DawidSzcz/attendence_verifier/README.md

# Arduino
W folderze verifier_board znajduje się kod wgrany na Arduino.

Fotografie urządzenia na bazie arduino:

Zmotowane urządzenie

# Attendence Verifier
Podrepozytorium z kodem aplikacji do zarządzania obecnością studentów na wykładzie w php/yii2.

Więcej informacji wewnątrz submodułu.

# Praca
Tekst pracy magisterskiej w tex/pdf

# Student Base
Podrepozytorium z kodem aplikacji do zarządzania danymi studentó w php/symfony4. 

Więcej informacji wewnątrz submodułu.
