DawidSzcz/attendence_verifier/praca/dawid_szczyrk_258352.tex

 % Opcje klasy 'iithesis' opisane sa w~komentarzach w~pliku klasy. Za ich pomoca
% ustawia sie przede wszystkim jezyk i~rodzaj (lic/inz/mgr) pracy, oraz czy na
% drugiej stronie pracy ma byc skladany wzor oswiadczenia o~autorskim wykonaniu.

\documentclass[declaration,shortabstract, mgr]{iithesis}
\usepackage{graphicx}
\usepackage[utf8]{inputenc}
\usepackage{url}

%%%%% DANE DO STRONY TYTUłOWEJ
% Niezaleznie od jezyka pracy wybranego w~opcjach klasy, tytul i~streszczenie
% pracy nalezy podac zarowno w~jezyku polskim, jak i~angielskim.
% Pamietaj o~madrym (zgodnym z~logicznym rozbiorem zdania oraz estetyka) recznym
% zlamaniu wierszy w~temacie pracy, zwlaszcza tego w~jezyku pracy. Uzyj do tego
% polecenia \fmlinebreak.
\polishtitle {System kontroli obecności na podstawie elektronicznych legitymacji studenckich}
\englishtitle {Students attendance verification system\\ with the use of electronic student's card}
\polishabstract{
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
\indent Dodatkowo w~ramach referowanego projektu wykonano internetową aplikację - elektroniczny dziennik - umożliwiającą katalogowanie zebranych przy pomocy weryfikatora obecności.
Użytkownikowi umożliwiono zarejestrowanie indywidualnego konta w~serwisie, w~którego kontekście możliwe jest tworzenie struktury wykładów i~zajęć odpowiadającej rzeczywistemu kalendarzowi prowadzącego. Aplikacja została wykonana przy użyciu frameworka języka PHP - Yii2.
Wirtualny dziennik nie przechowuje informacji o~studentach i~do poprawnego działania wymaga dostępu do serwisu udostępniającego takie dane.\\
\indent Podczas pracy nad projektem nie było możliwości podłączenia się do żadnego istniejącego systemu uczelnianego udostępniającego dane studentów. Z~tego powodu, jako element projektu, została stworzona aplikacja - w~oparciu o~framework Symfony4 - umożliwiająca pobranie danych studenta i~udostępniająca w~tym celu RESTowe API.\\
\indent Obie stworzone aplikacje wraz z~połączonymi z~nimi bazami danych osadzone zostały w~chmurze w~sposób zapewniający bezpieczeństwo i~niezawodność.}

\englishabstract{
\begin{center}
\subsubsection{Abstract}
\end{center}
\indent Within the following project, a~student attendance verification system with usage of Electronic Students Card (ESC) was developed. \\
\indent The presented work describes a~process from problem analysis and demands defining to developing the final version of the multi-component project. The final system consists of Internet applications for collecting and managing students presence data, and an electronic device made for this project with the usage of the Arduino platform. \\
\indent The electronic device - the verificator - provides a~comprehensive user interface and is responsible for collecting data about student presences. The final circuit was made based on the Arduino Uno board, extended with plenty of additional parts such as an RFID module and USB Host Shield. All interconnected parts were put in a~plastic box to make it comfortable for use and transportation. \\
\indent For managing data collected by the verificator, an Internet application was developed. It allows a~user to create an account, and manage presences data in its context. It is possible to create a~composition of lectures and classes, which corresponds with the real calendar of a~lecturer. It was developed with the usage of the PHP framework - Yii2. \\
\indent The system was designed not to relate to concrete student's data management system, in order to be flexible about a~university system it is connected with. \\
\indent Additionally, a~system which correlates the Electronic Student Card UID with the information about students was developed. It provides REST API, to retrieve demanded information. The implementation provides fake data but can be easily replaced by real API. It was created based on the PHP framework - Symfony4. \\
\indent Both created services along with databases connected with them were deployed in the cloud system with respect to proper security and reliability standards.
}
% w pracach wielu autorow nazwiska mozna oddzielic poleceniem \and
\author {Dawid Szczyrk}
% w przypadku kilku promotorow, lub koniecznosci podania ich afiliacji, linie
% w ponizszym poleceniu mozna zlamac poleceniem \fmlinebreak
\advisor {dr Jakub Michaliszyn}
%\date {} % Data zlozenia pracy
% Dane do oswiadczenia o~autorskim wykonaniu
%\transcriptnum {} % Numer indeksu
%\advisorgen {dr. Jana Kowalskiego} % Nazwisko promotora w dopelniaczu
%%%%%

%%%%% WLASNE DODATKOWE PAKIETY
%
%\usepackage{graphicx,listings,amsmath,amssymb,amsthm,amsfonts,tikz}
%
%%%%% WłaASNE DEFINICJE I POLECENIA
%
%\theoremstyle{definition} \newtheorem{definition}{Definition}[chapter]
%\theoremstyle{remark} \newtheorem{remark}[definition]{Observation}
%\theoremstyle{plain} \newtheorem{theorem}[definition]{Theorem}
%\theoremstyle{plain} \newtheorem{lemma}[definition]{Lemma}
%\renewcommand \qedsymbol {\ensuremath{\square}}
% ...
%%%%%

\begin{document}

\chapter{Wprowadzenie}

\indent Panująca na świecie pandemia COVID-19 zmusiła ludzi do porzucenia wielu do tej pory dobrze sprawdzających się rozwiązań na rzecz takich, które pomogą zapobiec rozprzestrzenianiu się wirusa. Gospodarki i~codzienne życie ludzi zostały przestawione na tryby tzw. nowej normalności.\\
\indent W niemniejszym stopniu obecna sytuacja dotknęła pracy uniwersytetów. Po okresie zdalnego nauczania, wraz z~nowym rokiem akademickim tradycyjne formy nauczania wracają do sal wykładowych, a~troska o~bezpieczeństwo studentów i~pracowników uniwersytetu narzuca reorganizację życia akademickiego.\\
\indent Jednym z~elementów funkcjonowania instytucji naukowych, który powinien zostać dostosowany do nowych wymogów sanitarnych, jest prowadzenie listy obecności na zajęciach stacjonarnych. Zgodnie z~ustępem 3 paragrafu 2 zarządzenia nr 116/2020 rektora Uniwersytetu Wrocławskiego \cite{uwr} podczas wszystkich zajęć na uczelni, które odbywają się w~formie stacjonarnej lub hybrydowej obligatoryjne jest prowadzenie listy obecności uczestników zajęć. Obecna forma realizowana poprzez podawanie sobie przez studentów kartki, na której spisane zostają ich dane, prowokuje dodatkowe niebezpieczeństwo zakażenia wirusem. \\
\indent Dodatkową zachętą do usprawnienia obecnego rozwiązania, jest cytowane powyżej zarządzenie rektora Uniwersytetu Wrocławskiego ustalające, że od semestru zimowego 2020 na wszystkich prowadzonych zajęciach obowiązkowe jest zbieranie listy obecności. \\
\indent Względy zdrowotne nie są jedynym uzasadnieniem konieczności optymalizacji identyfikowania osób biorących udział w~zajęciach. Obecna forma tego procesu jest uciążliwa, zajmuje kilka pierwszych minut zajęć, a~studenci się rozpraszają podając sobie listę obecności. Istotnym czynnikiem, który należy wziąć pod uwagę jest również ochrona danych osobowych, do której w~dzisiejszym świecie przykłada się coraz większą wagę.\\
\indent W dobie współczesnych zdobyczy technologicznych można uznać za zaskakujące, że wciąż trwamy przy tym procesie. Wydawać by się mogło, że obecne podejście jest tak zakorzenione w~akademickiej kulturze, że nie ma możliwości go zmienić. Istnieją jednak opracowania, które wskazują, że warto jest wdrażać nowoczesne rozwiązania, ponieważ ma to bezpośrednie przełożenie na prędkość sprawdzania obecności \cite{lcd}. Zostało dodatkowo sprawdzone \cite{theory_base}, że obecność ma wprost proporcjonalny wpływ na wyniki w~nauce i~odsetek uczniów porzucających studia przed ich ukończeniem. Wskazane zostało, że sprawdzanie obecności ma znaczenie nie tylko jako forma przymusu, ale również jako wyraz troski uczelni o~swoich studentów i~ma wpływ na ich morale.\\

\chapter{Analiza problemu}
\section{Przegląd obecnego sposobu sprawdzania obecności}
\indent W celu doprecyzowania wymagań stawianych przed projektowanym systemem rozważono proces weryfikowania obecności na zajęciach prowadzonych przez Uniwersytet Wrocławski\\
\indent Sprawdzanie listy uczestnictwa jest w~dużej mierze uzależnione od preferencji prowadzącego i~zwyczajów panujących na konkretnym wydziale - przykładowo obecność może być potwierdzona słownie - poprzez kolejne wywołanie osób z~listy albo pisemnie - poprzez udostępnienie listy, na którą uczestnicy będą zobowiązani się wpisać.\\
\indent Dla uproszczenia dalszych rozważań przyjęto za ogólnie stosowaną metodę pisemną - która według obserwacji autora jest stosowana częściej - i~na tej podstawie wyodrębnić czynności, które składają się na wypełnienie listy obecności.\\
\indent Weryfikacja uczestnictwa w~zajęciach jest czynnością na pozór oczywistą, po bliższym przyjrzeniu się całej procedurze okazuje się jednak, że daje się ona rozłożyć na jeszcze prostsze elementy. \\

\begin{itemize}
\item Przygotowanie kartki z~listą obecności (przypisanie listy obecności do zajęć których będzie ona dotyczyła).
\item Udostępnienie kartki uczestnikom oraz wpisywanie się na listę.
\item Weryfikacja poprawności zebranej listy poprzez przeliczenie osób obecnych na zajęciach.
\item Przeniesienie zebranych danych do uczelnianego systemu.
\end{itemize}

\indent Powyższy schemat zbierania listy obecności podatny jest na dodatkowe błędy. Nie trudno wyobrazić sobie sytuację, w~której student intencjonalnie podał nie swoje dane w~celu zaliczenia obecności innej osobie. Kolejnym czynnikiem, który może doprowadzić do błędów na ostatecznej liście obecności jest błąd ludzki podczas przenoszenia danych z~kartki do uczelnianego systemu komputerowego. Taki błąd trudno jest od razu wychwycić ze względu na to, że studenci zazwyczaj nie przeglądają na bieżąco list obecności dostępnych np. na USOSie.\\
\indent Pierwszym elementem nadającym się do usprawnienia jest samo tworzenie listy obecności z~informacją na temat zajęć, których ta lista będzie dotyczyła. Fizyczna lista, poza czasem poświęconym na jej stworzenie, musi być po odbytych zajęciach przechowywana - co stwarza ryzyko jej zgubienia. Dodatkowo istnieje prawdopodobieństwo, że trafi w~niepowołane ręce i~ktoś wpisze na nią dodatkowe nazwiska. Do tego wszystkiego dochodzi jeszcze aspekt ekologiczny, ponieważ każda kolejna kartka generuje wymagające utylizacji śmieci. \\
\indent Również udział studentów w~rejestrowaniu własnej obecności może ulec optymalizacji. Wpisanie własnego imienia i~nazwiska, a~czasem numeru albumu zabiera czas, naraża na upublicznienie dane osobowe i~utrudnia studentowi śledzenie wykładu.\\
\indent Weryfikacja poprawności listy jest nie tylko pracochłonna, ale również podatna na błędy. Czas poświęcony na policzenie uczestników rośnie wprost proporcjonalnie do ich liczby. Dodatkowo prowadzący zajęcia może się pomylić lub ktoś może dopisać się do listy już po tym sprawdzeniu.\\
\indent Z całą pewnością usprawnienia wymaga proces przenoszenia danych z~fizycznego nośnika do uczelnianego systemu komputerowego. Problemem jest nie tylko to, że podczas wpisywania obecności do komputerowego systemu można popełnić błąd, ale również to, że jest to proces czasochłonny.\\

\section{Istniejące i~możliwe realizacje zagadnienia}
\subsection{Podłączenie czytnika RFID bezpośrednio do komputera}
\indent Popularnym pomysłem usprawniającym system weryfikacji obecności jest skorzystanie technologii RFID (Radio-frequency identification). Wykorzystuje ona pole elektromagnetyczne do śledzenia na niewielkie odległości tagów (etykiet) RFID\cite{rfid_itself} - małych transmiterów fal radiowych zdolnych do przechowywania danych umożliwiających zdalną identyfikację. Tagi często mają formę kart, breloków lub innych łatwych w~transporcie i~przechowywaniu przedmiotów.\\
\indent W opracowaniu \cite{rfid_serial} przedstawiono projekt weryfikatora obecności zrealizowany przy pomocy radio technologii. Każdemu studentowi został przypisany tag z~unikatowym identyfikatorem. System składa się z~czytnika etykiet podłączonego do komputera przy użyciu portu szeregowego oraz aplikacji komputerowej zdolnej do rozpoznawania zbliżonych do czytnika tagów i~zapamiętywania którzy studenci zeskanowali swoje karty w~trakcie zajęć. \\
\indent Ciekawym pomysłem przedstawionym w~tym projekcie jest przekazanie osobnego tagu prowadzącemu zajęcia. Zbliżenie tej etykiety na początku i~na końcu zajęć do czytnika wyznacza ramy czasowe, podczas których obecność może zostać zaliczona studentom. Dodatkowo zastosowano tutaj podejście, w~którym uczestnik powinien rejestrować swoje pojawienie się, jak i~opuszczenie zajęć - jest to odstępstwo od tradycyjnej formy zbierania obecności. \\
\indent W projekcie można zaobserwować kilka wad. Wykorzystany czytnik RFID jest urządzeniem w~całości dostarczonym przez producenta. Można spodziewać się że jest to rozwiązanie drogie, a~samego urządzenia nie będzie dało się rozszerzyć o~dodatkowe funkcjonalności. \\
\indent Taka architektura pociąga za sobą konieczność ciągłego połączenia z~komputerem oraz dodatkowego okablowania. Może to powodować problemy logistyczne, jeśli trzeba korzystać z~systemu w~różnych salach.\\
\indent Sama aplikacja komputerowa katalogująca zebrane obecności również poddana jest ograniczeniom. Korzystanie z~tego systemu możliwe jest wyłącznie na komputerach, na których zainstalowano taką aplikację, co jest rozwiązaniem uciążliwym. Baza danych zapamiętująca obecności współdzielona jest pomiędzy poszczególne instancje aplikacji na różnych komputerach, jest więc ona udostępniona publicznie, co ułatwia nieautoryzowany dostęp.

\subsection{Podłączenie przy pomocy kabla ethernetowego}
\indent W opracowaniu opisanym w~pracy\cite{ethernet} zaproponowano podobną realizację, tym razem w~oparciu o~bezpośrednie podłączenie czytnika do internetu kablem RJ45. Wykorzystywane urządzenie jest stworzone na bazie Arduino Uno rozszerzonym o~moduł RFID i~gniazdo pozwalające podłączyć kabel ethernetowy. \\
\indent Zaproponowany projekt rozwiązuje problem konieczności korzystania z~komputera w~bezpośrednim połączeniu z~czytnikiem, a~wybrany układ elektroniczny pozwala rozszerzyć urządzenie o~dodatkowe funkcjonalności. Łączność internetowa pozwala na natychmiastowe odnotowywanie obecności w~bazie, co na pewno jest wygodnym rozwiązaniem. \\
\indent W treści opracowania nie został poruszony problem połączenia obecności z~zajęciami, na których została ona odnotowana. W~przypadku rozszerzenia systemu o~kolejne czytniki podłączone do sieci i~korzystania z~wielu urządzeń jednocześnie, nie będzie możliwości rozszyfrowania, z~jakich zajęć pochodzą spływające do serwera dane. \\
\indent Jedynym możliwym sposobem na komunikację urządzenia z~użytkownikiem jest w~tym wypadku buzzer, co może okazać się niewystarczające do wyrażenia stanu urządzenia. W~razie kłopotów z~łącznością albo anteną RFID nie ma możliwości wygodnego sygnalizowania problemu.

\subsection{Samodzielny czytnik }
\indent W cytowanym we wstępie opracowaniu\cite{lcd}, w~celu rozwiązania powyższego problemu zaproponowano wykorzystanie z~wyświetlacza LCD, z~którego użytek robi opisany w~tej pracy układ elektroniczny. Przedstawione w~pracy urządzenie poza czytnikiem RFID, zdolne jest również do wyświetlania treściwych komunikatów potwierdzających udane odnotowanie karty studenta. \\
\indent Trudno jednak w~tym wypadku dyskutować z~innymi rozwiązaniami technicznymi zawartymi w~tej pracy, ponieważ motywem przewodnim tego opracowania jest pokazanie, że sprawdzanie obecności przy pomocy tagów RFID przebiega szybciej niż w~klasycznym podejściu.

\subsection{Aplikacja internetowa}
\indent To najprostsze rozwiązanie składające się z~jednolitego systemu, w~którym jednocześnie można odnotowywać obecności uczestników zajęć oraz je przechowywać i~przeglądać. Jej niewątpliwym plusem jest całkowite wyeliminowanie problemu związanego z~przenoszeniem danych do systemu katalogującego obecności, ponieważ dane wprowadzane są wprost do systemu. Identyfikacja konkretnych zajęć, w~ramach których rejestrowana jest obecność, odbywałaby się na początku zajęć poprzez wejście w~kontekst odpowiedniego wykładu w~aplikacji. Obecność uczestników na zajęciach byłaby sprawdzana przez prowadzącego i~od razu wprowadzana do systemu. \\

\subsection{Urządzenie rejestrujące obecności za pośrednictwem sieci bezprzewodowej}
\indent W przypadku tego rozwiązania mikrokontroler zastałby rozszerzony o~moduł do bezprzewodowej łączności z~internetem, a~stworzona aplikacja udostępniałaby interfejs do odnotowywania obecności. \\
\indent Na etapie planowanie tego rozwiązania wyniknęły komplikacje. Ten sposób wysyłania danych do aplikacji katalogującej obecności wymagałby umożliwienia powiązania obecności z~zajęciami, na których zostały zebrane. \\
\indent Wymagałoby to dołączenia dodatkowego interfejsu, który by to umożliwiał, co jeszcze bardziej komplikowałoby projektowane urządzenie. Dodatkowo ograniczyłoby to zbiór układów scalonych, z~których można by skorzystać, ponieważ musiałby on posiadać wystarczającą ilość pamięci, pinów i~innych potrzebnych peryferiów.

\section{Określenie wymagań wobec projektu}
\indent W poprzednim rozdziale wspomniano o~wielu możliwych realizacjach problemu weryfikowania uczestnictwa w~zajęciach, co jest tylko niewielkim wycinkiem możliwych do wykonania projektów. W~opracowaniu \cite{review} wspomniano o~wielu przedsięwzięciach, z~których na wyróżnienie zasługują:

\begin{itemize}
\item Skorzystanie z~telefonu komórkowego i~łączności bluetooth w~celu odnotowania obecności.
\item Wykorzystanie odcisku palca do dodatkowego potwierdzenia tożsamości studenta.
\item Użycie kamery i~rozpoznawania twarzy w~celu identyfikacji wchodzących na wykład studentów.
\end{itemize}

\indent Analiza powyższych rozwiązań wraz z~ich mocnymi i~słabymi stronami pozwoliła wyłonić zbiór wymagań wobec projektowanego systemu. Wymagania zostały dobrane pod kątem poprawienia wydajności klasycznego sposobu weryfikowania obecności, co zostało rozważone w~rozdziale 2.1, oraz możliwości jakie dają współczesne technologie, które zostały opisane powyżej.

\subsubsection{Urządzenie powinno udostępniać następujące funkcjonalności:}

\begin{enumerate}
\item Zarejestrowanie obecności uczestnika zajęć przy pomocy tagu RFID.
\item Wyświetlanie jasnych komunikatów odnośnie stanu urządzenia.
\item Powiązanie obecności z~zajęciami, podczas których zostały zebrane.
\item Potwierdzenie tożsamości uczestnika odnotowującego swoją obecność.
\item Katalogowanie zebranych danych i~generowanie raportów podsumowujących.
\item Wygodne przeniesienie obecności zebranych przez czytnik do aplikacji przechowującej dane.
\end{enumerate}

\section{Określenie struktury projektu}
\indent Finalnie w~referowanym projekcie rozdzielono proces zbierania danych od ich przechowywania i~przetwarzania.\\
\indent Realizacja projektu opiera się na fakcie, że polskie uczelnie powszechnie korzystają z~Elektronicznych Legitymacji Studenckich (ELS), które zawierają wbudowany tag RFID. \\
\indent Komponent umożliwiający studentowi odnotowanie swojej obecności na wykładzie - weryfikator - został oparty o~platformę Arduino. Urządzenie zostało rozszerzone o~moduły umożliwiające realizację założeń z~poprzedniego rozdziału.\\
\indent Dodatkowo częścią urządzenia będzie zegar RTC umożliwiający zapamiętanie godziny, o~której odnotowane zostały obecności, a~więc powiązanie ich z~konkretnymi zajęciami, oraz wyświetlacz LCD + Buzzer, pozwalające na wygodne korzystanie z~samodzielnego urządzenia. \\
\indent Sposobem na potwierdzenie tożsamości studenta będzie w~wypadku realizowanego projektu porównanie zdjęcia na legitymacji z~twarzą osoby, która zbliża ją do czytnika. Za tę weryfikację odpowiedzialny będzie prowadzący.\\\\

\indent Rolę oprogramowania odpowiedzialnego za katalogowanie zebranych przez weryfikator danych będzie pełnić ogólnodostępna aplikacja internetowa - elektroniczny dziennik, umożliwiający założenie konta i~zarządzanie zebranymi obecnościami w~kontekście całego przedmiotu i~w kontekście pojedynczych zajęć. Dodatkowo ma on umożliwiać generowanie raportów ze zagregowanymi danymi tak, aby dało się łatwo prześledzić obecności w~kontekście całego semestru. \\
\indent Wirtualny dziennik zaprojektowano w~taki sposób, żeby był niezależny od danych studentów. Dzięki takiemu podejściu w~łatwy sposób można przełączyć cały system na korzystanie z~baz danych na różnych uczelniach. Uniknie się także konieczności przechowywania wrażliwych danych w~systemie. \\
\indent Ze względu na to, że na etapie realizowania założonego projektu nie uzyskano dostępu do serwisu udostępniającego dane wrocławskich studentów, została stworzona dodatkowa aplikacja, niezależna od innych części projektu. Umożliwia ona powiązanie danych pobranych z~legitymacji studenckiej z~danymi pozwalającymi na identyfikację jej posiadacza. Jest to aplikacja rozłączna względem systemu zarządzającego obecnościami osób uczestniczących w~zajęciach, wystawiająca RESTowe API.

\chapter{Realizacja}
\section{Weryfikator - czytnik legitymacji studenckich}
\indent Zgodnie z~wymaganiami projektowane urządzenie powinno udostępniać co najmniej następujące możliwości:
\begin{itemize}
\item Podłączenie zewnętrznego nośnika danych.
\item Stworzenie pliku, na którym zapamiętani zostaną uczestnicy zajęć.
\item Zebranie informacji z~elektronicznej legitymacji studenckiej, potwierdzające obecność uczestników.
\item Wyświetlanie informacji o~stanie urządzenia, w~szczególności sukcesu odczytania danych z~legitymacji.
\item Zapamiętanie czasu, w~którym zebrane zostały obecności.
\end{itemize}
\indent Dodatkowo cała elektronika powinna zostać schowana wewnątrz plastikowego opakowania, a~zasilanie dostarczane za pomocą przenośnego akumulatora lub kabla podłączonego do sieci elektrycznej. Opakowanie powinno zostać wyposażone w~otwory na kabel zasilający, zewnętrzny nośnik danych oraz wyświetlacz. Czytnik kart RFID powinien być tak zlokalizowany, aby umożliwić łatwe zebranie danych z~ELS.
\subsection{Zastosowana platforma i~peryferia}
\indent Arduino to cała platforma programistyczna umożliwiająca łatwe projektowanie i~testowanie układów składających się z~wielu elektronicznych modułów. Podstawą każdego projektu Arduino jest układ elektroniczny oparty na mikroprocesorze. Pod egidą tego systemu udostępniony jest cały wachlarz wersji takich układów, różniących się rodzajem kontrolera i~udostępnionymi peryferiami (przykładowo: slot na kartę SD, gniazdo RJ-45, wbudowany wyświetlacz, moduł WIFI). Dodatkowo platforma udostępniona jest na licencji open hardware, co sprawiło, że z~projektem związana jest olbrzymia międzynarodowa społeczność entuzjastów elektroniki. Częścią platformy jest również środowisko programistyczne umożliwiające wgrywanie własnych programów na podłączoną do komputera płytkę - Arduino IDE.\\
\indent Ciekawą opcją udostępnioną użytkownikom platformy jest możliwość skonstruowania własnej płytki z~procesorem na bazie powszechnie dostępnych schematów gotowych układów. Jest to korzystne rozwiązanie, gdy projektantowi zależy na ograniczeniu kosztów układu. W~referowanym rozwiązaniu skorzystano jednak z~jednej z~gotowych płytek.\\
\indent Podstawą projektowanego weryfikatora została płytka Arduino Uno oparta na mikroprocesorze AVR ATmega328. Kontroler w~tym układzie jest bardzo prosty, posiada ograniczone zasoby, co wymusza dodatkowy wysiłek włożony w~zarządzanie pamięcią i~czasem procesora. Kontroler jest wyposażony w~następujące zasoby:
\begin{itemize}
\item 32kB Flash - przestrzeń na kod programu.
\item 2kB SRAM zajmowane przez pamięć operacyjną.
\item porty SPI, I2C, szeregowy.
\item Jednostka obliczeniowa o~częstotliwości zegara 20MHz.
\end{itemize}
\indent Dodatkowo, w~celu zapewnienia wszystkich wymaganych funkcjonalności przez projektowany weryfikator, skorzystano z~następujących dodatkowych modułów:
\begin{itemize}
\item Czytnik RFID - do odczytywania danych z~legitymacji studenckiej wyposażonej w~interfejs zbliżeniowy. Czytnik podłączony jest przez port szeregowy.
\item USB Host Shield - dodające gniazdo USB, umożliwiające podłączenie pendriva, korzystający z~drugiego portu SPI.
\item Wyświetlacz LCD wraz z~potencjometrem do ustawiania kontrastu, przekazujący użytkownikowi informacje na temat stanu urządzenia.
\item RTC - zegar czasu rzeczywistego z~baterią do zapamiętywania czasu zbierania danych, korzystający z~interfejsu I2C.
\item Buzzer piezo wydający dźwiękowe sygnały w~razie sukcesu.
\end{itemize}
\subsection{Konstrukcja}
\indent Do skonstruowania ostatecznego układu z~zebranych elementów użyto dodatkowo:
\begin{itemize}
\item Płytki stykowej.
\item Trzech rezystorów 220 Ohm.
\item Kilkudziesięciu kabli różnej długości.
\item Jednego przycisku do resetowania zegara.
\end{itemize}
\indent Cały układ został osadzony w~plastikowym opakowaniu z~wywierconymi otworami.\\
\begin{figure}[h]
\caption{Wykorzystane komponenty elektroniczne}
\centering
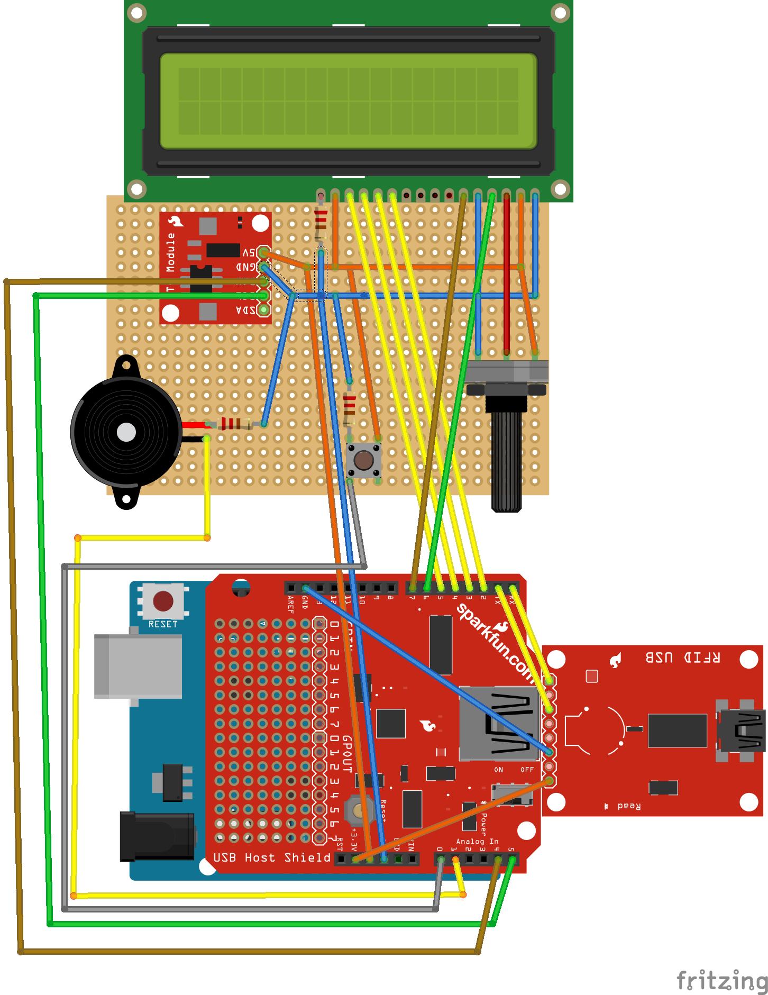
[picture p1: praca/circuit.png]

\end{figure}
\begin{figure}[h]
\caption{Gotowe urządzenie}
\centering
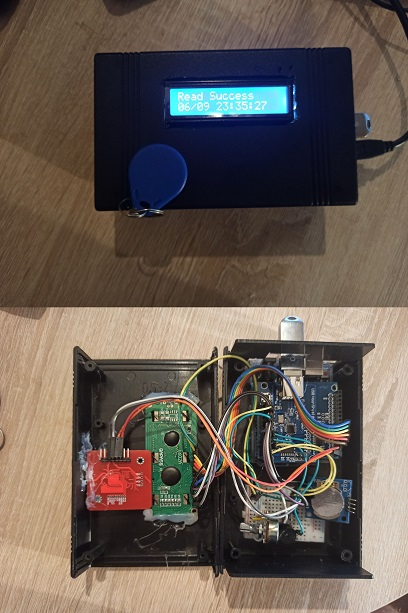
[picture p2: praca/arduino1.jpg]

\end{figure}
\clearpage
\subsection{Działanie}
\indent Osią działania zaprojektowanego weryfikatora jest interakcja z~dwoma zewnętrznymi urządzeniami. Jednym z~nich jest nośnik danych, na którym zapisane zostaną obecności uczestników zajęć. W~realizowanym projekcie tę rolę pełni pendrive sformatowany w~systemie FAT. W~zależności od tego, czy w~danym momencie pendrive jest podłączony, urządzenie jest w~stanie oczekiwania na drugie z~zewnętrznych narzędzi - Elektroniczną Legitymację Studencką. Dodatkowo weryfikator jest zdolny do wyświetlanie komunikatów o~swoim stanie na ekranie LCD i~wydawania sygnałów dźwiękowych przy pomocy brzęczka. Częścią urządzenia jest również zegar RTC, który pozwala śledzić aktualny czas. Weryfikator monitoruje swój własny stan i~jest zdolny do wykrywania błędów takich jak błąd inicjalizacji podłączonego pendrive'a, błąd zapisu odczytanych danych na nośniku, błąd zegara RTC - spowodowanego najczęściej rozładowaną baterią\\.
\indent Kod weryfikatora projektowano z~myślą o~tym, żeby łatwo dało się przedstawić przebieg programu na diagramie. Struktura kodu jest przemyślana w~taki sposób, żeby podczas jednego przebiegu pętli głównej wykonywał się jedynie kod powiązany z~aktualnym stanem urządzenia. Taki układ nie tylko pozwala zwięźle opowiadać o~działaniu urządzenia, ale również ułatwia testowanie poprawności podczas pisania kodu i~montowania urządzenia.\\
\indent Weryfikator w~danej chwili może znajdować się w~jednym z~12 stanów. Na przedstawionym diagramie stany oczekujące na zdarzenie oznaczono cieniowaniem. Opis poszczególnych stanów znajduje się w~załączniku~\ref{a:stany} do niniejszej pracy.
\begin{figure}[h]
\caption{Diagram stanów}
\centering
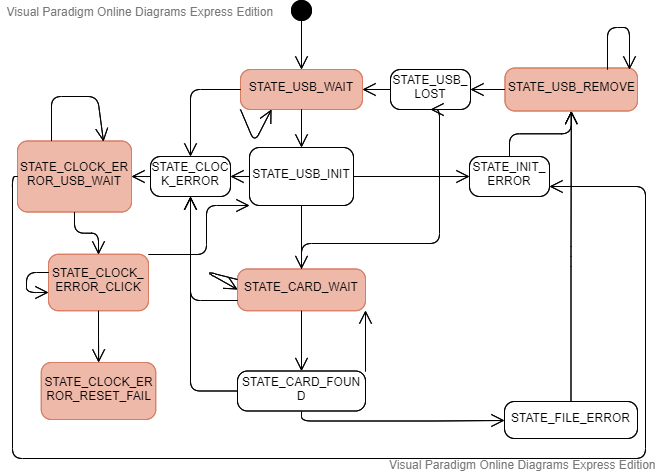
[picture p3: praca/state_machine.png]

\end{figure}
\subsection{Procedura resetowania zegara RTC}
\indent Urządzenie korzysta z~dodatkowego układu elektronicznego - zegara RTC. Moduł jest zdolny śledzić aktualny czas nawet w~przypadku odłączenia weryfikatora od zasilania. Do układu dołączona jest w~tym celu bateria, która raz na dwa lata może ulec rozładowania.\\
\indent W takim przypadku urządzenie wyświetli komunikat 'Clock Error' i~przejdzie w~tryb oczekiwania na podanie nowego czasy. W~celu zresetowania zegara należy wykonać następujące kroki (weryfikator wyświetla na ekranie informacje podpowiadające co zostało do zrobienia):
\begin{enumerate}
\item Rozkręcić plastikowe opakowanie.
\item Wymienić baterię w~module RTC.
\item Podłączyć do weryfikatora pendrive zawierający w~głównym katalogu plik o~nazwie 'tdav', który w~pierwszej linijce zawierał będzie datę w~nieodległej przyszłości w~formacie "YYYY/MM/DD hh:mm:ss".
\item W momencie kiedy podana w~pliku data będzie aktualna - nacisnąć przycisk wewnątrz urządzenia.
\end{enumerate}
\indent Czas urządzenie można zresetować w~dowolnym momencie. Wystarczy wyjąć baterię i~odłączyć weryfikator od zasilania.
\subsection{Koszt urządzenia oraz zasilanie}
\indent Komponenty niezbędne do zmontowania urządzenia są łatwo dostępne w~internecie i~dobrze zaopatrzonych sklepach z~elektroniką. Na pełny koszt gotowego weryfikatora składają się następujące elementy:
\begin{enumerate}
\item Kable, rezystory, płytka stykowa 10 zł.
\item Zegar RTC 5 zł.
\item Wyświetlacz LCD 10 zł.
\item PN532 - moduł RFID 30 zł.
\item USB Host Shield 35 zł.
\item pudełko 10 zł.
\item klon Arduino Uno - 20 zł.
\item Buzzer - 3 zł.
\end{enumerate}

\indent Sumaryczny koszt to w~przybliżeniu 123 zł. Dla porównania układ Raspberry Pi kosztuje około 200 zł. Po doliczeniu kosztów dodatkowych komponentów okaże się, że weryfikator na bazie Arduino jest około dwukrotnie tańszy.\\
\indent Rozważając koszty związane z~budową i~eksploatacją urządzenia należy również wziąć pod uwagę sposób zasilania. Kabel zasilający z~jakiego korzystano podczas projektowania urządzenia (12V, 1.5A) kosztuje około 10 zł. Urządzenie można również podłączyć do power banka. Standardowy akumulator o~pojemności 10000 mAh, powinien zasilać urządzenie przez około 40h.

\subsection{Napotkane problemy}
\subsubsection{Dwa moduły korzystające z~interfejsu SPI}
\indent Podczas wstępnej fazy planowania podstawą weryfikatora miała być płytka Arduino Leonardo. \\
\indent Podobnie jak w~ostatecznej wersji miała ona zostać rozszerzona o~USB Host Shield oraz moduł RFID - oba używają interfejsu SPI. Każdy z~tych komponentów osobno współpracował poprawnie z~Arduino Leonardo. Problemy pojawiły się, kiedy połączono wszystko w~jedną całość w~celu zapisywania odczytanych danych z~ELS na podłączonym pendrivie. \\
\indent Podczas montowania układu okazało się, że w~tej wersji płytki piny interfejsu SPI znajdują się w~magistrali ICSP, która była już zajęta przez moduł USB w~taki sposób, że nie było możliwości podłączenia tam innych kabli. \\
\indent Próba dolutowania kabli do magistrali CSP na płytce USB Host Shield (z shielda wystają jedynie milimetrowe pinu CSP), zakończyła się przepaleniem połączeń wewnątrz tego układu i~w konsekwencji jego uszkodzeniem. \\
\indent W celu rozwiązania problemu z~portem SPI ostatecznie wykorzystano wersję UNO, która interfejs SPI ma doprowadzony również na piny 10-13. \\
\begin{figure}[h]
\caption{Uklad USB Host shield ze wskazaniem na zakończenia magistrali CSP}
\centering
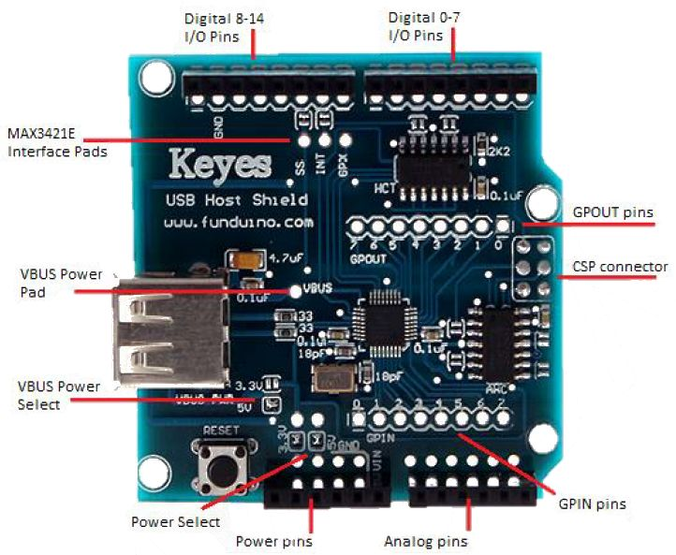
[picture p4: praca/usb_host_shield.jpg]

\end{figure}

\subsubsection{Problemy z~odczytaniem danych z~ELS}
\indent W początkowej wersji urządzenie korzystało z~modułu RFID - MFRC-522. Ten komponent bez zarzutów współpracował z~załączonymi w~zestawie tagami, jednak bardzo słabo wykrywał Elektroniczną Legitymację Studencką. Odczytanie UIDu z~ELS zajmowało zazwyczaj parę minut. Żeby rozwiązać ten problem, zmieniono moduł RFID na taki o~lepszym zasięgu - PNS532. Pierwsze próby zwiastowały pełny sukces - próby odczytania danych z~ELS przebiegały bez zarzutu. \\
\indent Problem pojawił się jednak przy współpracy nowego modułu z~resztą układu. Jak już zostało wcześniej wspomniane, Arduino Uno posiada jeden port SPI, do którego można podłączyć więcej urządzeń. Niestety Arduino było w~stanie współpracować tylko z~jednym z~dwóch komponentów - albo USB Host shield, albo modułem PNS532. Ostatecznie okazało się jednak, że moduł PNS532 udostępnia również inne porty, dzięki czemu udało się go podłączyć przy pomocy portu szeregowego.
\subsubsection{Wypełniona pamięć operacyjna}
\indent W miarę dołączania kolejnych komponentów do układu, tzn. zegara RTC, brzęczka oraz wyświetlacza LCD, zaczęły pojawiać się problemy z~pamięcią. \\
\indent Pierwsza skończyła się pamięć operacyjna, której kontroler posiada jedynie 2KB. Objawiało się to nagłym zawieszaniem się wykonywania programu bez jednoznacznego określenia przyczyny.\\
\indent Udało się rozwiązać ten problem dzięki większej dyscyplinie w~korzystaniu z~pamięci. Ograniczono liczbę zmiennych globalnych, a~największy efekt przyniosło przeniesienie wykorzystywanych w~programie napisów z~pamięci operacyjnej do pamięci flash, do czego służy dyrektywa PROGMEM.\\
\indent Pamięć flash jest przeznaczona do przechowywania kodu programu i~nie ma do niej swobodnego dostępu, jak w~przypadku pamięci operacyjnej. Korzystanie z~niej do przechowywania stałych jest uciążliwe, ponieważ każdy bajt danych musi być odczytywany osobno, jednak dzięki temu nie było potrzeby przechowywania wszystkich łańcuchów znaków jednocześnie w~pamięci SRAM.
\subsubsection{Wypełniona pamięć flash}
\indent Przeniesienie łańcuchów znaków do pamięci flash, chociaż poprawiło wydajność pamięci operacyjnej, to spowodowało wyczerpanie przestrzeni przeznaczonej na kod programu. \\
\indent Pamięć flash jest bardziej pojemna niż SRAM, ponieważ w~tym wypadku jest to aż 32KB do dyspozycji programisty, jednak duża liczba bibliotek do obsługi peryferiów doprowadziła do wyczerpanie się również tej przestrzeni. \\
\indent Ułatwieniem w~przypadku optymalizowania wykorzystania pamięci flash jest to, że przestrzeń zajmowana przez kod programu jest stała po kompilacji. Nie ma więc obawy, że w~trakcie przebiegu programu nastąpi nagły wzrost i~przekroczenie pojemności. Wystarczy dostosować się do limitu 32 KB. \\
\indent Problem został przezwyciężony poprzez ograniczenie liczby funkcji, które zadeklarowano w~programie, oraz schowanie komunikatów wysyłanych na serial monitor wewnątrz dyrektyw preprocesora \#if DEBUG serial.println(''SETUP"); \#endif. Dzięki temu można było łatwo wyłączyć kod programu odpowiedzialny za debugowanie.\\
\subsubsection{Moduł WIFI}
\indent W pierwszej wersji planowanego weryfikatora miał on się łączyć z~siecią za pomocą modułu WIFI. Wielu problemów przysporzył jednak układ ESP8266, odpowiedzialny za tę łączność. Po wgraniu sterownika przestawał on być wykrywany przez komputer i~Arduino.\\
\indent Pomimo testowania kilku takich układów, za każdym razem pojawiał się ten sam problem. Ostatecznie zrezygnowano z~wykorzystania modułu ESP8266 ze względu na zmianę koncepcji.

\subsection{Inne koncepcje weryfikatora}
\indent Na etapie projektowania weryfikatora, jako jego podstawa brany był pod uwagę układ Raspberry Pi. Ostatecznie zrezygnowano z~tego pomysłu, ze względu na to, że takie urządzenie mogłoby wymagać utrzymywania systemu operacyjnego w~aktualnej wersji. Za wykorzystaniem Arduino przemawia również cena takiego układu i~fakt, że jest on bardzo dobrze znany studentom Instytutu Informatyki UWr z~zajęć Systemów Wbudowanych.\\
\indent Projektując układ należało również podjąć decyzję z~jakiego nośnika skorzystać do przenoszenia danych z~weryfikatora do aplikacji zarządzającej obecnościami. Poza wykorzystanym w~ostatecznym rozwiązaniu pendrivem brano również pod uwagę skorzystanie z~karty SD \\
\indent Ze względu na większą dostępność i~łatwiejsze podłączenie klasycznego pendriva do komputera (nie każdy komputer posiada slot na kartę SD), zdecydowano się na tę właśnie możliwość. Później okazało się, że ta decyzja miała swoje konsekwencje.\\
\indent Po pierwsze USB Host Shield zajął magistralę ICSP, będącą jedynym wyjściem pinów interfejsu SPI w~układzie Arduino Leonrado, co w~konsekwencji doprowadziło do zmiany wersji płytki na UNO. \\
\indent Kolejnym utrudnieniem, spowodowanym przez korzystanie z~pendriva, były problemy z~dostępnością biblioteki obsługującej pamięć w~tej formie. Podstawowa biblioteka obsługująca układ USB Host Shield nie przewiduje wykorzystania złącza USB do podłączenia pamięci masowej. \\
\indent Ostatecznie skorzystano z~mniej popularnej biblioteki do obsługi tego narzędzia - UsbFat\cite{usbfat}, która jednak okazała się być słabo opisana.

\section{Elektroniczny dziennik}
\indent W celu wygodnego przetwarzania zebranych danych o~obecnościach stworzona została aplikacja internetowa - elektroniczny dziennik. W~serwisie użytkownik może założyć konto, w~jego kontekście stworzyć strukturę prowadzonych przez siebie zajęć i~uzupełniać listę obecnych na nich studentów.\\
\indent Dziennik umożliwia przeglądanie obecności studentów, którzy wzięli udział w~zajęciach oraz wygenerowanie raportu w~formacie CSV ze zagregowanymi obecnościami.
\subsubsection{Struktura dziennika}
\indent Użytkownikowi serwisu po założeniu konta i~zalogowaniu ukazuje się lista instancji wykładów, które są przypisane do jego konta i~na których może dokonać standardowych operacji przeglądania/edytowania/usuwania/dodawania. Instancja wykładu składa się z~nazwy, opisu, listy uczestników oraz listy zajęć w~jej ramach. Instancję wykładu można rozumieć jako zajęcia prowadzone przez jednego prowadzącego z~grupą studentów w~ramach jednego przedmiotu. \\
\indent Do instancji wykładu zostaje przypisana grupa studentów, którzy są zapisani na zajęcia prowadzone przez użytkownika w~ramach wykładu. Przykładową listą uczestników będzie więc jedna grupa studentów uczestniczących w~ćwiczeniach prowadzonych przez jednego pracownika uniwersytetu w~ramach jednego przedmiotu. Dodatkowo, generowany raport z~obecności na jednej instancji wykładu będzie odnosił się tylko do studentów znajdujących się na tej liście.\\
\indent Każda instancja wykładu posiada skończony zbiór zajęć, których pojedyncza instancja składa się z~daty i~godziny oraz przypisanej do niej listy obecności. Taka instancja może być rozumiana jako pojedyncze zajęcia jednej grupy studentów. Na listę obecności mogą zostać wpisani studenci, którzy nie są wpisani na listę uczestników instancji wykładu. Będą widoczni w~przeglądzie konkretnych zajęć w~graficznym interfejsie dziennika jako wolni słuchacze, jednak nie zostaną wzięci pod uwagę przy generowaniu raportu dla instancji wykładu.\\

\indent Posługując się przykładem jednego przedmiotu, prowadzonych w~ramach pojedynczego semestru, struktura w~dzienniku będzie wyglądała następująco: zajęcia w~ramach przedmiotu będą rozdzielone pomiędzy konta wykładowcy i~wszystkich ćwiczeniowców prowadzących zajęcia. \\
\indent Wykładowca stworzy na swoim koncie w~elektronicznym dzienniku instancję wykładu, przypisane do niego zostaną wszystkie wykłady, a~listą uczestników będą wszyscy studenci zapisani na ten przedmiot. Na Listę obecności pojedynczych zajęć będą więc wpisani wszyscy studenci, którzy w~trakcie odbywania się wykładu w~sali Instytutu Informatyki przyłożą swoją legitymację do weryfikatora.\\
\indent Ćwiczeniowcy na swoich kontach utworzą osobne instancje wykładu, przypiszą do nich zajęcia odpowiadające prowadzonym przez siebie cotygodniowym ćwiczeniom. Do listy studentów przypisanej do tej instancji wykładu powinni zostać dodani Ci, którzy zapisali się do grupy danego prowadzącego. \\
\indent Pojedynczy przedmiot prowadzony w~ramach jednego semestru zostanie więc podzielony na tyle instancji wykładu w~elektronicznym dzienniku, ilu jest prowadzących i~wykładowców. Każdy z~nich będzie zbierał obecności tylko w~ramach prowadzonych przez siebie zajęć. \\
\indent Jeśli użytkownik elektronicznego dziennika w~ramach jednego przedmiotu prowadzi wiele różnych zajęć. np. wykład i~ćwiczenia albo ćwiczenia z~różnymi grupami studentów, powinien on przypisać do swojego konta kilka instancji wykładu z~przypisanymi do nich grupami studentów oraz instancjami prowadzonych przez niego zajęć z~tą grupą.

\subsubsection{Interfejs użytkownika}
\indent Interfejs użytkownika elektronicznego dziennika jest prosty i~składa się tylko z~elementów umożliwiający tworzenie struktury instancji wykładów i~zajęć oraz zarządzaniem obecnościami. Wygląd strony został oparty na frontendowym frameworku Bootstrap\cite{bootstrap}.
Podstrony zostały ostylowane w~sposób zapewniający przejrzystość i~stosunkowo nowoczesny wygląd. \\
\indent Cały interfejs aplikacji został zrealizowany w~języku angielskim i~na chwilę obecną nie ma możliwości przełączenia się na język polski.\\
\subsubsection{Przegląd instancji wykładów}
\indent Główną podstroną widoczna dla użytkownika po zalogowaniu się na konto jest przegląd instancji wykładów przypisanych do niego. Z~tego poziomu mogą zostać wykonane standardowe funkcje CRUD\cite{crud}.\\
\indent Formularz dodawania nowej instancji wykładu umożliwia załączenie pliku, na podstawie którego zostanie zainicjalizowana grupa uczestników instancji wykładu. Plik powinien zawierać listę numerów albumu studentów wypisanych po przecinku.\\
\indent Inicjalizacja listy zajęć jest możliwa w~jednym z~trzech trybów - pojedynczym, cotygodniowym lub comiesięcznym. W~razie wybrania którejś z~dwóch ostatnich opcji formularz umożliwi podanie początkowej i~końcowej daty, a~do wykładu zostaną przypisane zajęcia odpowiednio co siedem i~co trzydzieści dni od pierwszej z~nich. Formularz zakłada, że wszystkie zajęcia odbywać się będą o~tej samej godzinie. Użytkownik będzie miał możliwość zmiany godziny w~przeglądzie poszczególnych zajęć.\\
\subsubsection{Podgląd pojedynczej instancji wykładu}
\indent Po wejściu w~przegląd instancji wykładu aplikacja wyświetla informacje o~jej nazwie i~opisie. Dodatkowo w~dwóch domyślnie zwiniętych listach wyświetlona zostaje lista obecności i~lista zajęć. Użytkownik ma możliwość dodawania/usuwania elementów tych list. W~przypadku, kiedy student posiadał już zaliczone obecności w~ramach zajęć przyporządkowanych do tej instancji wykładu, a~zostanie usunięty z~listy uczestników, jego uczestnictwo zostanie zinterpretowane jako udział wolnego słuchacza w~zajęciach.\\
\indent W tym widoku użytkownik dostaje również możliwość wygenerowania raportu z~obecnościami w~formacie CSV.\\
\subsubsection{Podgląd pojedynczych zajęć}
\indent Ostatnim istotnym widokiem jest przegląd pojedynczych zajęć. Użytkownik otrzymuje możliwość zmodyfikowania ich daty i~godziny oraz wyświetlenia i~zarządzania listą obecności. Lista podzielona jest na dwie części - studentów, którzy są uczestnikami instancji wykładu, oraz wolnych słuchaczy. Każdy wiersz na pierwszej z~list pokolorowany jest na czerwono lub zielono w~zależności od tego, czy dany uczestnik był obecny na zajęciach. \\
\indent Interfejs umożliwia w~tym widoku wysłanie na serwer pliku z~obecnościami, które zostały wygenerowane przez weryfikator.\\
\subsubsection{Dodatkowe widoki}
\indent Aplikacja udostępnia dodatkowo widoki informacyjne związane z~funkcjonowaniem serwisu - Kontakt/Opis oraz związane z~funkcją logowania/rejestracji. Te części aplikacji są uproszczone i~w razie uruchomienia systemu w~wersji produkcyjnej będą wymagały uzupełnienia.

\subsubsection{Połączenie z~bazą studentów}
\indent Jak zostało określone podczas definiowania wymagań wobec projektu, dziennik elektroniczny jest niezależny od danych dotyczących studentów i~nie przechowuje ich w~żadnej formie.\\
\indent Podczas dodawania studentów do listy uczestników wykładu albo listy obecności na zajęciach aplikacja odwołuje się do zewnętrznego serwisu udostępniającego dane studentów. Korzystając z~podanych przez użytkownika informacji identyfikujących studenta - numeru albumu albo UIDu karty magnetycznej, odpytuje zewnętrzną aplikację poprzez udostępnione API. Kiedy dane studenta zostaną poprawnie pobrane, dziennik zapamiętuje jedynie identyfikator studenta w~zewnętrznym systemie. Przy każdym żądaniu wyświetlenia danych studentów aplikacja wykorzystuje zapamiętany identyfikator do wysłania zapytania do zewnętrznego serwisu. \\
\indent Takie podejście ma zasadnicze korzyści. Dzięki zapamiętywaniu zewnętrznego identyfikatora, aplikacja może uniknąć zapamiętywania wrażliwych danych. Pozwala to znacząco ograniczyć straty nawet w~przypadku naruszenia bezpieczeństwa serwisu. Dodatkowo taka architektura jest przygotowaniem systemu do współpracy z~rzeczywistymi źródłami danych o~studentach i~wpięcia do cyfrowego systemu istniejącej uczelni.\\
\subsubsection{Przegląd technologii}
\indent Aplikacja została napisana we frameworku Yii2\cite{yii}, będącym rozszerzeniem języka PHP. Cała architektura opiera się na modelu MVC. W~ramach definiowania modeli i~łączenia ich z~bazą korzystano ze wzorca ActiveRecord, a~kod związany z~przetwarzaniem innych źródeł danych w~serwisie wydzielono do osobnych serwisów w~ramach aplikacji.\\
\indent W projekcie frontendu korzystano z~frameworka Bootstap\cite{bootstrap} oraz gotowych komponentów\cite{kartik}\cite{da1}\cite{da2} wyświetlających edytowalne pola z~datą i~godziną. \\
\indent Dane wygenerowane w~trakcie funkcjonowania aplikacji przechowywane są w~relacyjnej bazie danych operującej na systemie PostreSQL\cite{psql}.\\
\indent Gotowa aplikacja została uruchomiona w~środowisku najnowszej wersji PHP - 7.4.\\
\indent Do zarządzania zależnościami serwisu wykorzystano system zarządzania pakietami Composer\cite{composer}.

\section{Baza studentów}
\indent Baza studentów jest aplikacją internetową, umożliwiającą zarządzanie danymi studentów i~udostępniającą API. Jej zadaniem jest imitowanie systemu istniejącej uczelni i~umożliwienie pobrania szczegółowych danych studenta po numerze albumu i~identyfikatorze przypisanym do Elektronicznej Legitymacji Studenckiej.\\
\indent Aplikacja została napisana w~technologii Symfony4\cite{symfony} z~biblioteką Doctrine\cite{doctrine} w~roli ORMa pośredniczącego w~komunikacji z~bazą danych w~systemie PostgreSQL. Do stworzenia interfejsu umożliwiającego zarządzanie danymi studentów wykorzystany został framework Bootstrap.\\
\indent Ze względu na fakt, że aplikacja ma za zadanie jedynie imitować działający system i~umożliwić działanie elektronicznego dziennika, funkcjonalności realizowane przez aplikację ograniczone zostały do minimum. Opis tego komponentu stanowi załącznik~\ref{a:bazastudentów}.

\section{Propozycja wdrożenia systemu}
\begin{figure}[h]
\caption{Architektura w~chmurze AWS}
\centering
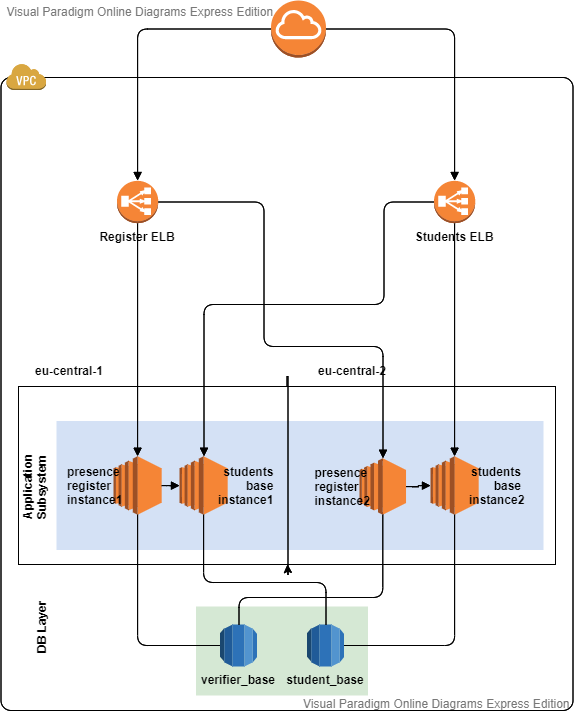
[picture p5: praca/AWS.png]

\end{figure}
\indent W celu prezentacji gotowego rozwiązania cały system został wdrożony na platformę przygotowaną przez Amazona - AWS\cite{aws} - udostępniającą część swoich funkcjonalności na rok za darmo w~ramach programu AWS Free Tier. \\
\indent Zaproponowana architektura to przykład trójwarstwowego podejścia do wdrażania systemów korzystających z~równoważenia obciążenia, serwerów uruchomieniowych aplikacji i~baz danych. \\
\indent Każda z~aplikacji utworzona jest w~dwóch instancjach w~różnych sieciach. Do obu serwisów przydzielony jest Load Balancer, który równoważy ruch pomiędzy istniejące instancje. W~przypadku braku dostępności któregoś z~serwerów, na których uruchomione zostały aplikacje, cały ruch przekazywany jest do drugiego z~nich.\\
\indent W celu zapewnienia bezpieczeństwa, bazy danych znajdują się w~osobnych sieciach, do których dostęp został umożliwiony jedynie z~sieci, w~których znajdują się aplikacje dziennika elektronicznego i~bazy studentów. \\
\indent Dodatkowo aplikacje pobierają informacje o~swojej konfiguracji ze zmiennych środowiskowych serwera, na którym zostały uruchomione. Są to informacje o~sposobie połączenia z~bazą danych, a~w przypadku dziennika elektronicznego również odnośnik i~dane do logowania do aplikacji bazy studentów.

Załącznik \ref{a:narzedzia} zawiera dodatkowo listę wszystkich narzędzi wykorzystanych w~tym projekcie.

\chapter{Podsumowanie i~możliwości rozwoju systemu}
\indent Niniejsza praca w~kompleksowy sposób przedstawia proces od projektowania do wdrożenia systemu do monitorowania obecności studentów na zajęciach uniwersyteckich. System jest łatwy w~obsłudze, jednak ze względu na to, że jak dotąd nie został włączony w~istniejącą architekturę cyfrową żadnego uniwersytetu, może wymagać dostosowania. \\
\indent Projekt pozwala na prowadzenie kontroli obecności na wielu zajęciach jednocześnie i~wygodne przetwarzanie zebranych danych. Na tle przytoczonych w~rozdziale 2 przykładów innych realizacji podobnych systemów, niniejszy projekt jest opracowany w~sposób najbardziej kompleksowy. W~dalszej części tego rozdziału omówione są możliwe kierunki rozwoju tego projektu.

\section{Powiązania pomiędzy instancjami wykładu}
\indent Dziennik elektroniczny na aktualnym stadium rozwoju nie jest świadomy powiązania pomiędzy instancjami wykładu wchodzącymi w~skład jednego rzeczywistego przedmiotu. Każdy prowadzący tworzy odrębną strukturę zajęć na swoim koncie i~brakuje informacji na temat tego, w~ramach jakiego przedmiotu są te zajęcia prowadzone. \\
\indent Dzięki rozszerzeniu aplikacji o~taką wiedzę elektroniczny dziennik byłby w~stanie generować raport podsumowujący dla całego przedmiotu, agregując statystyki obecności na wykładzie i~ćwiczeniach dla każdego studenta. Dodatkowo można byłoby zautomatyzować procedurę odrabiania zajęć na innych ćwiczeniach. \\
\indent Takie rozwiązanie wymagałoby szczególnej ostrożności, ponieważ informacje z~różnych kont byłyby wzajemnie widoczne. Aktualnie taka sytuacja nie występuje.
\section{Zautomatyzowana weryfikacja}
\indent Mankamentem zaprezentowanego w~powyższej pracy podejścia jest konieczność manualnej weryfikacji, czy osoba zbliżająca legitymację do czytnika jest rzeczywiście jej właścicielem. W~opracowaniu \cite{fingerprint} przedstawiono projekt udostępniania informacji o~studencie w~oparciu o~kartę RFID oraz dodatkową weryfikację poprzez sprawdzenie linii papilarnych. W~systemie weryfikującym obecność na zajęciach można byłoby skorzystać z~podobnego rozwiązania.\\
\indent Innym dającym się zastosować podejściem jest system do rozpoznawania twarzy.
\section{Integracja z~uczelnianym systemem}
\indent Projektowany system od początku miał na celu integrację z~zewnętrznym źródłem informacji o~studentach. Bazę studentów, która w~projekcie jest osobną aplikację, łatwo można by zastąpić przez akademicką platformę. Kolejnym polem do integracji jest system logowania. Korzystanie z~konta z~USOSa byłoby ułatwieniem dla korzystających z~aplikacji pracowników i~studentów oraz pozwoliłoby uniknąć przechowywania w~systemie wrażliwych danych związanych z~utworzonymi kontami.
\section{Udostępnienie systemu studentom}
\indent Rozwinięciem systemu byłoby udostępnienie studentom funkcjonalności zalogowania się i~wglądu do ich aktualnych statystyk związanych z~obecnościami. Istotnym problemem byłoby tworzenie kont przypisanych do właściwej osoby. Można byłoby to rozwiązać poprzez integrację z~uczelnianym systemem do logowania albo udostępniając studentom konta zakładane przez administratora, który zajmowałby się potwierdzeniem tożsamości.
\section{Informowanie zainteresowanych o~obecnościach}
\indent W cytowanym we wstępie opracowaniu\cite{theory_base} wskazane jest, że sprawdzanie obecności ma znaczenie nie tylko jako forma przymusu, ale również jako wyraz troski uczelni o~swoich studentów. Wskazane jest, że `wczesna interwencja` w~przypadku opuszczania przez ucznia zajęć może zapobiec przerwaniu przez niego studiów. Nasuwa to bardzo wiele możliwości rozwoju aplikacji weryfikującej obecności. Referowaną platformę można by wyposażyć w~narzędzia dp informowania studenta o~tym, że limit jego nieobecności na pewnych zajęciach jest bliski wyczerpania się. \\
\indent Możliwe stałoby się automatyczne informowanie organów uczelnianych o~kłopotach studenta na podstawie jego absencji. \\
\section{Platforma do szybkiego reagowania}
\indent Idąc tym tropem, integrując uczelniane systemy, udostępniając studentom wgląd w~ich obecności i~umożliwiając interakcje poprzez kanały takie jak mail czy sms można z~prostej aplikacji stworzyć rozbudowaną platformę do monitorowania wyników studenta i~adekwatnego reagowania w~przypadku wykrycia potencjalnych problemów. Wiążąc informacje na temat tego, na jakim etapie studiów znajduje się student z~jego aktualnymi wynikami, byłoby możliwe automatyczne dopasowanie pomocy, takiej jak rozmowa z~pracownikiem uczeni odpowiedzialnym za studentów, czy zaproponowanie dodatkowych zajęć.

\begin{thebibliography}{9}
	\bibitem{theory_base}
		Debbie Bevitt and Chris Baldwin and Jane Calvert,
		\textit{Intervening Early: Attendance and Performance Monitoring as a~Trigger for First Year Support in the Biosciences}
		2016, Bioscience Education
		\url{https://doi.org/10.3108/beej.15.4}
	\bibitem{fingerprint}
		Asiya R. Shaikh, Dipali.S.Sahane, Pradip V.Wagh
		\textit{RFID and FINGERPRINT based Students Database System}
		2020
		\url{https://www.irjet.net/archives/V7/i4/IRJET-V7I4445.pdf}
	\bibitem{bluetooth}
		Vishal Bhalla and Tapodhan Singla and Ankit Gahlot and Vijay Gupta
		\textit{Bluetooth Based Attendance Management System}
		2013
		\url{http://citeseerx.ist.psu.edu/viewdoc/summary?doi=10.1.1.645.1573}
	\bibitem{ethernet}
		Oo, Zaw Lin and Win Lai, Theint and Than, Maung Maung
		\textit{Web Server Base RFID Attendance Record Systems}
		2018
		\url{https://www.researchgate.net/publication/333115623_Web_Server_Base_RFID_Attendance_Record_System/comments}
	\bibitem{review}
		Patel, Unnati and Swaminarayan, Priya
		\textit{Computer Science and Management Studies Development of a~Student Attendance Management System Using RFID and Face Recognition: A Review}
		2014, International Journal of Advance Research in Computer Science and Management Studies
		\url{https://www.researchgate.net/publication/325819350_Computer_Science_and_Management_Studies_Development_of_a_Student_Attendance_Management_System_Using_RFID_and_Face_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}
	\bibitem{rfid_serial}
		Arulogun, Oladiran and Olatunbosun, Adeboye and A., Fakolujo and Olayemi Mikail, Olaniy
		\textit{RFID-Based Students Attendance Management System}
		2013, International Journal of Engineering and Scientific Research
		\url{https://www.researchgate.net/publication/235598499_RFID-Based_Students_Attendance_Management_System}
	\bibitem{lcd}
		Shoewu, Oluwagbemiga and Makanjuola, N. and Ajasa, Abiodun and Oluwafemi J., Ayangbekun
		\textit{Design and Implementation of an Rfid Based Automated Students Attendance System R BASAS}
		2015, JOURNAL OF ADVANCEMENT IN ENGINEERING AND TECHNOLOGY
		\url{https://www.researchgate.net/publication/235598499_RFID-Based_Students_Attendance_Management_System}
	\bibitem{rfid_itself}
		\url{https://en.wikipedia.org/wiki/Radio-frequency_identification}	
	\bibitem{uwr}
		ZARZĄDZENIE Nr 116/2020 Rektora Uniwersytetu Wrocławskiego z~dnia 3 września 2020 r
		\url{https://bip.uni.wroc.pl/download/attachment/25560/nr_116_2020_zarzadzenie_funkcjonowanie-uwr-w-zwiazku-z-covid_19.pdf}
	\bibitem{bootstrap}
		\url{https://getbootstrap.com/}	
	\bibitem{kartik}
		\url{https://github.com/kartik-v/yii2-widget-timepicker}	
	\bibitem{da1}
		\url{https://github.com/2amigos/yii2-date-time-picker-widget}	
	\bibitem{da2}
		\url{https://github.com/2amigos/yii2-date-picker-widget}	
	\bibitem{yii}
		\url{https://www.yiiframework.com/}
	\bibitem{composer}
		\url{https://getcomposer.org/}	
	\bibitem{psql}
		\url{https://www.postgresql.org/}
	\bibitem{doctrine}
		\url{https://www.doctrine-project.org/}
	\bibitem{symfony}
		\url{https://symfony.com/}	
	\bibitem{symfony}
		\url{https://en.wikipedia.org/wiki/Representational_state_transfer/}
	\bibitem{aws}
		\url{https://en.wikipedia.org/wiki/Amazon_Web_Services}	
	\bibitem{usbfat}
		\url{https://github.com/greiman/UsbFat}
	\bibitem{crud}
		\url{https://pl.wikipedia.org/wiki/CRUD}	
	\bibitem{rest}
		\url{https://en.wikipedia.org/wiki/Representational_state_transfer}	

\end{thebibliography}

\appendix
\chapter{Załączniki}
\section{Opis stanów weryfikatora}\label{a:stany}
Weryfikator posiada 12 możliwych stanów:
\begin{itemize}
\item STATE\_USB\_WAIT - oczekiwanie na pendrive - ekran wyświetla informację - "Insert pendrive". Próba inicjalizacji nośnika zajmuje około 5 sekund dlatego wyświetlany czas jest aktualizowany z~opóźnieniem.
\item STATE\_USB\_INIT - inicjalizacja pendriva - po odnalezieniu pendriva wyświetlana jest informacja "USB Inserted". W~przypadku błędu inicjalizacji - przejście do stanu STATE\_INIT\_ERROR, w~razie sukcesu na podstawie aktualnego czasu stworzona i~zapamiętana zostaje nazwa YY-MM-DD-hh\_mm\_ss dla pliku, który będzie przechowywał zebrane UIDy.
\item STATE\_CARD\_WAIT - oczekiwanie na kartę RFID - ekran: ''Scan Card". W~razie wykrycia odłączenia pendriva przejście do stanu STATE\_USB\_LOST.
\item STATE\_CARD\_FOUND - zapisywanie UIDu do pliku - otwarcie pliku o~zapamiętanej nazwie i~zapisanie do niego odczytanego UIDu. W~razie błędu przy zapisie przejście do stanu STATE\_FILE\_ERROR, w~przypadku sukcesu sygnał dźwiękowy, wyświetlenie informacji ''Read Success" i~powrót do stanu STATE\_CARD\_WAIT.
\item STATE\_INIT\_ERROR - błąd inicjalizacji pendriva - ekran: "Init Error".
\item STATE\_USB\_REMOVE - oczekiwanie na odłączenie pendriva. Wyświetlacz:\\''Reinsert USB". W~razie wykrycia odłączenia pendriva przejście do stanu STATE\_USB\_LOST.
\item STATE\_USB\_LOST - odłączono pendrive - ekran: "USB removed", sygnał dźwiękowy oraz przejście do stanu STATE\_USB\_WAIT.
\item STATE\_FILE\_ERROR - błąd zapisu do pliku - ekran: ''Open file error", przejście do stanu STATE\_USB\_REMOVE.
\item STATE\_CLOCK\_ERROR - błąd zegara - w~razie wykrycia problemów z~zegarem w~którymś ze stanów [STATE\_USB\_WAIT, STATE\_CARD\_WAIT, \\STATE\_CARD\_FOUND, STATE\_USB\_INIT, STATE\_USB\_REMOVE] sterowanie przechodzi do tego stanu. Wyświetlona zostaje informacja: ''Clock Error", następnie sterowanie przechodzi do STATE\_CLOCK\_ERROR\_USB\_WAIT.
\item STATE\_CLOCK\_ERROR\_USB\_WAIT - oczekiwanie na pendrive z~czasem - wyświetlacz "Insert pendrive with time". Sterowanie pozostaje w~tym stanie, do czasu kiedy na zewnętrznym nośniku wykryty zostanie plik o~nazwie tdav, który w~pierwszym wierszu będzie zawierał datę w~formacie "YYYY/MM/DD hh:mm:ss". W~przypadku wykrycia poprawnego pliku program zapamiętuje datę z~pliku tdav i~przechodzi w~stan STATE\_CLOCK\_ERROR\_CLICK.\\
- W razie błędu przy inicjalizacji pendriva program przechodzi do stanu \\STATE\_INIT\_ERROR. \\
- W razie wykrycia pendriva i~nie wykrycia pliku o~nazwie tdav wyświetlona zostaje informacja "Upload time tdav".\\
- W razie złego formatu pierwszej linijki w~pliku tdav wyświetlona zostaje informacja: "Bad date format".
\item STATE\_CLOCK\_ERROR\_CLICK - oczekiwanie na reset - wyświetlacz: ''Click to reset". Sterowanie pozostaje w~tym stanie, do czasu kiedy zostanie przyciśnięty guzik resetu. Po naciśnięciu guzika na zegarze zostaje ustawiona zapamiętana data, wyświetlony zostaje komunikat "Time set", a~sterowanie przechodzi do STATE\_USB\_INIT. Jeśli podczas ustawiania czasu na zagarze wystąpi błąd program przechodzi w~stan STATE\_CLOCK\_ERROR\_RESET\_FAIL.
\item STATE\_CLOCK\_ERROR\_RESET\_FAIL - błąd resetowania czasu. Wyświetlacz: ''Clock Reset Fail". Ze względu na brak możliwości ustawienia poprawnego czasu jest to stan, z~którego urządzenie nie może wrócić do poprawnego funkcjonowania.
\end{itemize}

\section{Opis bazy studentów}\label{a:bazastudentów}
\subsubsection{Zarządzanie informacjami o~studentach}
\indent Administrator systemu może zalogować się na stworzone w~systemie konto i~wykonać na danych studentów standardowe operacje CRUD. Dodatkowo użytkownik ma możliwość wysłania na serwer pliku w~formacie JSON ze zbiorczymi danymi studentów, które ma zamiar dodać do systemu. Studenci dodani w~kontekście jednego konta, są dostępni tylko z~perspektywy tego konta.
Pozwala to na stworzenie w~aplikacji odrębnych przestrzeni odpowiadających systemom różnych instytucji, które chciałyby korzystać z~takiego serwisu.\\
\indent Przechowywane dane studentów:
\begin{itemize}
\item user\_id - identyfikator użytkownika bazy danych.
\item album\_no - numer albumu studenta, unikalny w~kontekście użytkownika który stworzył dandy rekord.
\item name - imię.
\item surname - nazwisko.
\item start\_year - rok rozpoczęcia studiów.
\item semestr - aktualny semestr studiowania.
\item card\_uid - identyfikator ELS z~której korzysta student, unikalny w~kontekście użytkownika który stworzył dany rekord.
\end{itemize}
\subsection{Udostępnione API}
\indent Aplikacja udostępnia API w~architekturze REST\cite{rest}. Do autoryzacji zapytań o~dane studentów używany jest metoda HTTP Basic. Zautoryzowany użytkownik ma dostęp do tylko tych rekordów, które zostały utworzone w~kontekście jego konta.\\
\indent Lista przekazanych w~żądaniu parametrów powinna być zakodowana base64, a~dla parametrów, dla których w~bazie nie istnieje rekord zwracana jest pusta tablica.
\indent Możliwe requesty:
\begin{itemize}
\item GET: /api/students
\item GET: /api/students/id/{id}
\item GET: /api/students/card\_id/{card\_uid}
\item GET: /api/students/album\_no/{album\_no}
\end{itemize}

\section{Narzędzie wykorzystane w~trakcie realizacji}\label{a:narzedzia}
\begin{itemize}
\item PhpStorm - środowisko programistyczne ułatwiającego programowania w~PHP.
\item GIT - system kontroli wersji.
\item HeidiSQL - Klient bazy danych.
\item Postman - platforma do testowania API.
\item AWS console - narzędzie do zarządzania zasobami w~chmurze AWS.
\item Arduino IDE - środowisko umożliwiające pisanie kodu i~wgrywanie go na kontroler.
\item Putty - narzędzie do łączności ze zdalnym serwerem wykorzystujące protokół SSH.
\item Xdebug - rozszerzenie PHP umożliwiające debugowanie.
\item Profiler wbudowany w~Symfony4/Yii2.
\item Visual paradigm - narzędzie do projektowania diagramów.
\item Frizing - narzędzie do projektowania diagramów obwodów.
\end{itemize}

\end{document}
