DawidSzcz/attendence_verifier/praca/progmem.png

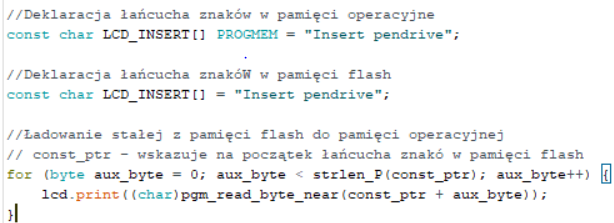
praca/progmem.png
