DawidSzcz/attendence_verifier/(commit log)

2020-08-26 wstep + arduino
2020-08-27 dzialjaca wersja arduino bez resetowania czasu
    [verifier_board.ino]
2020-08-28 arduino reset clock
2020-08-30 arduino - done + opis urzadzenia w pracy
2020-08-31 male zmiany w arduino + opis urządzenia w pracy + redakcja wstępu
